wattai/affordable-inverted-pendulum/scripts/bests/at-2026-08-16/README.md

# 2026-08-16 時点の設計：モデルと制御則

[2026-08-15 版](../at-2026-08-15/README.md) からの更新版です。

| ファイル | 内容 |
| --- | --- |
| [design_best_R14_controller.py](design_best_R14_controller.py) | 物理パラメータから 10 状態モデルを組み、離散化して LQR ゲインを求める設計スクリプト |
| [arduino_uno_sketch.ino](arduino_uno_sketch.ino) | 実機（Arduino Uno）に書き込んだスケッチ。上記モデルの $A_d, B_d$、オブザーバゲイン $L$、LQR ゲイン $K$ が直値で埋め込まれている |
| [inverted_pendulum_speed_feedback_discussion.md](inverted_pendulum_speed_feedback_discussion.md) | 車輪速度フィードバックが効いていない件の考察（別 AI による整理）。要点は §11 に取り込み |

## 08-15 版からの変更点

**モデルに効いた変更はむだ時間だけです。** $0.100 \to 0.110$ s（実測値の採用）。

| | 08-15 | 08-16 | モデルへの影響 |
| --- | --- | --- | --- |
| むだ時間 $L_d$ | 0.100 s | **0.110 s** | あり（$\lambda$: 60 → 54.545） |
| 重心高さ $h$ | 0.080 m | 0.060 m | **なし**（約分で消える、§2） |
| 振り子周期 $T_p$ | 0.75 s | 0.75 s（据え置き） | — |

途中 $T_p = 0.45$ s という測定値で設計した版がありましたが、実機は逆走して破綻しました。これは測り方の問題で、詳細は §9-3 に記録してあります。

以下、記号・モデル・制御則を数式で示し、最後にコード上の実測値との対応と注意点をまとめます。

---

## 1. 記号と状態変数

| 記号 | 意味 | 単位 |
| --- | --- | --- |
| $\theta$ | 機体の傾き角（直立が 0） | rad |
| $\dot\theta$ | 機体の角速度 | rad/s |
| $\varphi$ | 左右車輪角の平均 | rad |
| $\omega$ | 車輪角速度（モータ 1 次遅れ後の値） | rad/s |
| $z_1,\dots,z_6$ | 入力むだ時間を近似する 1 次遅れ 6 段の内部状態 | rad/s |
| $u$ | 車輪速度指令（下位ループへの入力） | rad/s |

状態ベクトルは

$$
x = \begin{bmatrix}\theta & \dot\theta & \varphi & \omega & z_1 & z_2 & z_3 & z_4 & z_5 & z_6\end{bmatrix}^{\mathsf T}\in\mathbb R^{10}
$$

観測量は上位 4 成分（IMU の角度・角速度、エンコーダの角度・角速度）です。

$$
y = Cx,\qquad C = \begin{bmatrix} I_4 & 0_{4\times 6}\end{bmatrix}
$$

## 2. 物理パラメータ

| パラメータ | 記号 | 値 |
| --- | --- | --- |
| 制御周期 | $T_s$ | 0.010 s |
| 車輪半径 | $r$ | 0.027 m |
| 重力加速度 | $g$ | 9.8 m/s² |
| 機体質量 | $m$ | 0.350 kg（実測、9V 電池 50 g 込み。下記注意） |
| 重心高さ | $h$ | 0.060 m（同上） |
| 振り子周期（実測） | $T_p$ | 0.75 s |
| モータ 1 次遅れ時定数 | $\tau_m$ | 0.070 s |
| むだ時間 | $L_d$ | 0.110 s |
| むだ時間の分割段数 | $N$ | 6 |
| モータゲイン | $k_m$ | **1.99**（2026-08-16 実測、§13） |

機体の有効慣性モーメントは、実測した振り子周期 $T_p$ から逆算します。

$$
I_{\mathrm{eff}} = \frac{T_p^{2}\, m g h}{4\pi^{2}}
$$

むだ時間 1 段あたりの時定数と遅れレートは

$$
\theta_d = \frac{L_d}{N} = 0.018333\ \mathrm{s},\qquad
\lambda = \frac{1}{\theta_d} = \frac{N}{L_d} = 54.545\ \mathrm{s^{-1}}
$$

### 注意：$m$ と $h$ はモデルに影響しない

$I_{\mathrm{eff}}$ を上式で定義しているため、モデル行列に現れる 2 つの係数から $m,h$ が約分で消えます。

$$
a_\theta = \frac{m g h}{I_{\mathrm{eff}}} = \frac{4\pi^{2}}{T_p^{2}} = 70.183854\ \mathrm{s^{-2}}
$$

$$
a_{bw} = \frac{m h r}{I_{\mathrm{eff}}\,\tau_m} = \frac{4\pi^{2} r}{T_p^{2} g\, \tau_m} = 2.762338\ \mathrm{s^{-2}}
$$

つまりモデルは $T_p,\ r,\ g,\ \tau_m$ だけで決まります。実測値は $m = 0.350$ kg（9V 電池 50 g 込み、2026-08-16 計測）・$h = 0.060$ m で、設計スクリプトと Arduino スケッチはこの値を使っています。08-15 版から $h$ が 0.080 → 0.060 m に変わっていますが、**得られる $A_c$ は $T_p$ が同じである限り完全に同一**です。

ハードウェアの詳細は [ハードウェア仕様](../../../docs/specs/hardware/README.md) を参照してください。

## 3. 連続時間モデル

$$
\dot x = A_c x + B_c u
$$

各行の意味は次のとおりです。

$$
\begin{aligned}
\dot\theta &= \dot\theta \\
\ddot\theta &= a_\theta\,\theta + a_{bw}\,\omega - a_{bw}k_m\,z_1 \\
\dot\varphi &= \omega \\
\dot\omega &= -\frac{1}{\tau_m}\omega + \frac{k_m}{\tau_m} z_1 \\
\dot z_i &= \lambda\,(-z_i + z_{i+1}) \quad (i=1,\dots,5) \\
\dot z_6 &= \lambda\,(-z_6 + u)
\end{aligned}
$$

- 第 2 式：重力による倒立不安定項 $a_\theta\theta$ と、車輪の駆動反力による機体への逆トルク。実際に車輪を押す量は遅延後の指令 $z_1$ なので、$\omega$ と $z_1$ の差分が機体角加速度に効きます。
- 第 4 式：モータを 1 次遅れとみなし、遅延後の速度指令 $z_1$ に時定数 $\tau_m$ で追従。
- 第 5・6 式：Padé ではなく **1 次遅れ 6 段のカスケード**で $L_d = 0.110$ s のむだ時間を近似（$u \to z_6 \to \cdots \to z_1$ の向きに伝播）。

行列で書くと

$$
A_c=\begin{bmatrix}
0 & 1 & 0 & 0 & 0 & 0 & 0 & 0 & 0 & 0\\
a_\theta & 0 & 0 & a_{bw} & -a_{bw} & 0 & 0 & 0 & 0 & 0\\
0 & 0 & 0 & 1 & 0 & 0 & 0 & 0 & 0 & 0\\
0 & 0 & 0 & -\tfrac{1}{\tau_m} & \tfrac{1}{\tau_m} & 0 & 0 & 0 & 0 & 0\\
0 & 0 & 0 & 0 & -\lambda & \lambda & 0 & 0 & 0 & 0\\
0 & 0 & 0 & 0 & 0 & -\lambda & \lambda & 0 & 0 & 0\\
0 & 0 & 0 & 0 & 0 & 0 & -\lambda & \lambda & 0 & 0\\
0 & 0 & 0 & 0 & 0 & 0 & 0 & -\lambda & \lambda & 0\\
0 & 0 & 0 & 0 & 0 & 0 & 0 & 0 & -\lambda & \lambda\\
0 & 0 & 0 & 0 & 0 & 0 & 0 & 0 & 0 & -\lambda
\end{bmatrix},\qquad
B_c=\begin{bmatrix}0\\0\\0\\0\\0\\0\\0\\0\\0\\ \lambda\end{bmatrix}
$$

## 4. 離散化

ゼロ次ホールドで $T_s = 10$ ms 離散化します。

$$
A_d = e^{A_c T_s},\qquad B_d = \int_0^{T_s} e^{A_c s}\,ds\ B_c
$$

$$
x[k+1] = A_d x[k] + B_d u[k]
$$

得られる $A_d$（有効数字 6 桁）：

$$
A_d=\begin{bmatrix}
1.003511 & 0.010012 & 0 & 0.000132 & -0.000111 & -0.000019 & -0.000002 & 0 & 0 & 0\\
0.702660 & 1.003511 & 0 & 0.025772 & -0.019740 & -0.005020 & -0.000881 & -0.000118 & -0.000013 & -0.000001\\
0 & 0 & 1.000000 & 0.009319 & 0.000572 & 0.000096 & 0.000012 & 0.000001 & 0 & 0\\
0 & 0 & 0 & 0.866878 & 0.101945 & 0.025943 & 0.004555 & 0.000608 & 0.000065 & 0.000006\\
0 & 0 & 0 & 0 & 0.579578 & 0.316134 & 0.086218 & 0.015676 & 0.002138 & 0.000233\\
0 & 0 & 0 & 0 & 0 & 0.579578 & 0.316134 & 0.086218 & 0.015676 & 0.002138\\
0 & 0 & 0 & 0 & 0 & 0 & 0.579578 & 0.316134 & 0.086218 & 0.015676\\
0 & 0 & 0 & 0 & 0 & 0 & 0 & 0.579578 & 0.316134 & 0.086218\\
0 & 0 & 0 & 0 & 0 & 0 & 0 & 0 & 0.579578 & 0.316134\\
0 & 0 & 0 & 0 & 0 & 0 & 0 & 0 & 0 & 0.579578
\end{bmatrix}
$$

$$
B_d^{\mathsf T}=\begin{bmatrix}0 & 0 & 0 & 0 & 0.000023 & 0.000256 & 0.002394 & 0.018070 & 0.104288 & 0.420422\end{bmatrix}
$$

対角の $0.579578 = e^{-\lambda T_s} = e^{-0.5455}$、$0.866878 = e^{-T_s/\tau_m}$ です。

これらの数値は Arduino のオブザーバ予測式にそのまま直値で埋め込まれています。車輪速度の行の $B_d$ 成分は $10^{-6}$ 未満なので、スケッチでは省いています。

> **設計上の約束事**：LQR は $A_d, B_d$ を **小数第 6 位で丸めた行列**に対して解いています（`USE_ARDUINO_6_DECIMAL_MATRICES = True`）。Arduino に写した行列と設計用行列を一致させるためで、フル精度で解くとゲインがわずかにずれます。

## 5. オブザーバ（定常カルマンフィルタ）

観測できるのは 4 成分だけなので、$z_1..z_6$ を含む全状態を推定します。ゲイン $L$ は離散リカッチ方程式から求めた定常カルマンゲインです（$Q_{\mathrm{obs}} = I_{10}$、$R_{\mathrm{obs}} = I_4$）。

$$
P = A_d P A_d^{\mathsf T} - A_d P C^{\mathsf T}\left(C P C^{\mathsf T} + R_{\mathrm{obs}}\right)^{-1} C P A_d^{\mathsf T} + Q_{\mathrm{obs}}
$$

$$
L = P C^{\mathsf T}\left(C P C^{\mathsf T} + R_{\mathrm{obs}}\right)^{-1}
$$

実機で実装されている更新則は

$$
\hat x[k] = A_d\,\hat x[k-1] + B_d\,u[k-1] + L\left(y[k] - C\,\hat x[k-1]\right)
$$

$$
L=\begin{bmatrix}
0.604602 & 0.064385 & -0.000002 & 0.000098\\
0.064385 & 0.662635 & 0.000009 & 0.000106\\
-0.000002 & 0.000009 & 0.618044 & 0.000949\\
0.000098 & 0.000106 & 0.000949 & 0.604201\\
0.005900 & -0.022480 & 0.000900 & 0.152556\\
0.003641 & -0.014118 & 0.000513 & 0.095090\\
0.001942 & -0.007677 & 0.000263 & 0.051310\\
0.000857 & -0.003463 & 0.000111 & 0.022946\\
0.000280 & -0.001161 & 0.000034 & 0.007627\\
0.000051 & -0.000219 & 0.000006 & 0.001426
\end{bmatrix}
$$

推定誤差 $e = x - \hat x$ の同次項は

$$
e[k] = (A_d - LC)\,e[k-1] \;-\; LC(A_d - I)\,x[k-1]
$$

第 1 項の固有値は最大 $0.6797$（すべて単位円内）です。第 2 項は、イノベーションの基準に予測値 $\bar x[k] = A_d\hat x[k-1] + B_d u[k-1]$ ではなく 1 サンプル前の $\hat x[k-1]$ を使っているために現れる項で、$A_d - I = O(T_s)$ なので小さいものの、厳密には教科書的な current estimator とは一致しません。実機はこの形で安定に動いています。

推定車輪速度は $\pm 20\cdot 2\pi$ rad/s に飽和させています。

## 6. LQR（バランス制御器）

評価関数

$$
J = \sum_{k=0}^{\infty}\left( x[k]^{\mathsf T} Q\, x[k] + u[k]^{\mathsf T} R\, u[k]\right)
$$

離散代数リカッチ方程式

$$
P = A_d^{\mathsf T} P A_d - A_d^{\mathsf T} P B_d\left(R + B_d^{\mathsf T} P B_d\right)^{-1} B_d^{\mathsf T} P A_d + Q
$$

最適ゲイン（離散系の正しい形）

$$
K = \left(R + B_d^{\mathsf T} P B_d\right)^{-1} B_d^{\mathsf T} P A_d,\qquad u[k] = -K\,\hat x[k]
$$

重みは

$$
Q = \mathrm{diag}(10,\ 1,\ 1,\ 1,\ 0,0,0,0,0,0),\qquad R = 1.8
$$

$Q$ の第 3 要素（車輪角 $\varphi$）は 2026-08-16 に 0 → 1 へ変更しました。0 のままだと $\varphi$ が評価から外れて閉ループ極が 1.0 ちょうどに残り、機体が前後にうろつきます。1 にすると $K_\varphi \ne 0$ となって位置を保持し、その極が 0.9917 へ移動します。得られる全ゲインは

$$
K_{\mathrm{full}} = \begin{bmatrix}-237.705891 & -28.381120 & -0.663467 & -3.484149 & 0.906499 & 0.785472 & 0.676866 & 0.577751 & 0.486363 & 0.403040\end{bmatrix}
$$

### 実機に載せた制御則

実験の結果、$z_1..z_6$ を直接フィードバックするより**上位 4 状態だけを使う**方がはるかに安定でした。したがって実装は

$$
u[k] = -K_\theta\hat\theta - K_{\dot\theta}\hat{\dot\theta} - K_\varphi\hat\varphi - K_\omega\hat\omega
$$

$$
K_\theta = -237.705891,\quad K_{\dot\theta} = -28.381120,\quad K_\varphi = -0.663467,\quad K_\omega = -3.484149
$$

$$
\Rightarrow\quad u[k] \approx 237.71\,\hat\theta + 28.38\,\hat{\dot\theta} + 0.66\,\hat\varphi + 3.48\,\hat\omega \quad [\mathrm{rad/s}]
$$

（$\hat\theta$ には後述の位置ホールド用トリムが引かれますが、既定では無効です。）

### 閉ループ極

| 構成 | 最大 $|\lambda|$ |
| --- | --- |
| 全 10 状態 LQR（$K_{\mathrm{full}}$） | 0.991736 |
| 実機構成（$z$ ゲインを 0 に切り落とした 4 状態） | 1.099362 |
| オブザーバ誤差 $A_d - LC$ | 0.683314 |

$Q_\varphi = 1$ としたことで、以前は 1.0 ちょうどに居座っていた車輪角の積分器モードが 0.9917 に入りました。$Q_\varphi = 0$ では $\varphi$ が可安定だが不可検出でモードが中立になり、機体が前後にうろつく原因になっていました。

4 状態版の $1.099$ は、**この 10 状態公称モデル単体では発散する**ことを意味します。設計スクリプト自身もこれを警告として出力します。ただし実機にはオブザーバ、下位のモータ／PWM ループ、エンコーダ特性、飽和、モデル誤差が加わっており、実験的には $z$ を直接フィードバックする構成より 4 状態構成の方が明確に良好でした。このスクリプトは「理論上の全状態 LQR」と「実際に成功した実装ゲイン」の両方を再現するためにこの形になっています。

## 7. 下位ループ（左右同期 + leaky PI）

上位が出した速度指令 $u$ を、左右 2 輪の PI ループへ渡します。$\varphi_A,\varphi_B$ を左右の車輪角、$\omega_A,\omega_B$ を左右の車輪速度として

$$
\Delta = \varphi_B - \varphi_A
$$

$$
e_A = u - \omega_A + k_{\mathrm{sync}}\Delta,\qquad
e_B = u - \omega_B - k_{\mathrm{sync}}\Delta
$$

積分項は漏れ（leaky）付きで、$\rho = 0.99$（時定数 $\approx T_s/(1-\rho) = 1$ s）：

$$
I_A[k] = e_A[k]\,T_s + \rho\, I_A[k-1],\qquad I_B[k] = e_B[k]\,T_s + \rho\, I_B[k-1]
$$

$$
u_A = \mathrm{sat}_{[-1,1]}\!\left(k_{pA} e_A + k_{iA} I_A\right),\qquad
u_B = \mathrm{sat}_{[-1,1]}\!\left(k_{pB} e_B + k_{iB} I_B\right)
$$

| パラメータ | 値 |
| --- | --- |
| $k_{\mathrm{sync}}$ | 1.20 |
| $k_{pA},\ k_{pB}$ | 0.025, 0.030 |
| $k_{iA},\ k_{iB}$ | 0.040, 0.050 |
| 積分漏れ $\rho$ | 0.99 |

左右で $k_p, k_i$ が非対称なのは、安定していたコードの実測値をそのまま残しているためです。$u_A, u_B$ は duty 比としてそのまま PWM に出力されます。

## 8. センサ処理と保護

- **機体角**：BNO055 の Euler-z からオフセット（起動時 300 サンプルの平均）を引いて rad へ変換。$|z| < 20^\circ$ の領域は Euler 表現が乱れるため、前回値を保持する処理を意図的に残しています。
- **機体角速度**：BNO055 ジャイロ $-\dot x$ をそのまま使用。
- **車輪角**：A/B 相を高速ポーリングして計数。ギア比が左右で異なります。

$$
\varphi_A = \mathrm{cnt}_A\cdot\frac{20}{14}\cdot\frac{2\pi}{48},\qquad
\varphi_B = \mathrm{cnt}_B\cdot\frac{20}{12}\cdot\frac{2\pi}{48}
$$

$$
\varphi = \frac{\varphi_A + \varphi_B}{2},\qquad \omega = \frac{\bar\omega_A + \bar\omega_B}{2}
$$

- **車輪速度の生値**：1 次 IIR で平滑（$\alpha = 0.8$）。
- **転倒保護**：$|\theta| > 35^\circ$ でモータ停止・積分器リセット。
- **タイミング**：MsTimer2 による 10 ms 周期（100 Hz）。ログは 1/5 に間引いて 20 Hz。

## 9. 実装上の注意（既知の差異）

実機の挙動を再現するうえで重要な、コードとモデルの食い違いです。**いずれも「安定していた状態を壊さない」ために意図的に、あるいは結果的に残されています。**

1. **`angleSpeedAverageA/B` は恒等的に 0**
   [arduino_uno_sketch.ino:572-578](arduino_uno_sketch.ino#L572-L578) の更新は `angleSpeedAverageA += angleSpeedAverageA / 100` という自己参照で、初期値 0・毎制御周期末に 0 リセットされるため、値は常に 0 のままです。結果として
   - オブザーバの第 4 観測 $y_4 \equiv 0$（イノベーション $e_4 = -\hat\omega$ になる）
   - 下位 PI の速度フィードバックが実質無効化され、$e_A = u + k_{\mathrm{sync}}\Delta$ となる

   コード中のコメントでも「下位ループを一から再調整しない限り直すな」と明記されています。

2. **モード名と中身の $R$ は一致させてあります（08-15 版からの変更）**
   08-15 版は `MODE_R14_4STATE` という名前のスロットに $R = 1.0$ の解が入っており、08-16 の実験で混乱の一因になりました。現在は `MODE_R18_4STATE`（$R = 1.8$、既定）と `MODE_R30_4STATE`（$R = 3.0$）で、名前と設計値が一致しています。参考用の `gainZ1..gainZ6` も $R = 1.8$ で統一しました。

3. **振り子周期 0.45 s は測定アーティファクト**
   車軸に紐を結んで測った 0.45 s は、紐自体が振れる 2 自由度系の固有モードであり、モデルが仮定する「車軸を固定した 1 自由度の剛体振り子」ではありません。平行軸定理より $T_p \ge 2\pi\sqrt{h/g} = 0.492$ s（$h = 0.060$ m）なので、0.45 s は車軸まわりの回転としては原理的に成立しません。爪で車軸を吊って測った 0.75 s を採用しています。

4. **位置ホールド外ループは既定で無効**
   `ENABLE_SLOW_POSITION_HOLD = false`。有効にすると 10 Hz で機体角の目標にトリムを加えます。

$$
\theta_{\mathrm{trim}}[k] = \alpha_p\,\theta_{\mathrm{trim}}[k-1] + (1-\alpha_p)\,\mathrm{sat}_{\pm 0.5^\circ}\!\left(-K_{\mathrm{pos}}(\varphi - \varphi_{\mathrm{ref}})\right)
$$

$$
\theta_{\mathrm{ctrl}} = \hat\theta - \theta_{\mathrm{trim}},\qquad K_{\mathrm{pos}} = 0.0010,\ \ \alpha_p = 0.90
$$

## 10. 再現方法

```bash
uv sync
uv run python scripts/bests/at-2026-08-16/design_best_R14_controller.py
```

物理パラメータ → $A_c, B_c$ → ZOH 離散化 → 6 桁丸め → 離散 LQR → Arduino 用定数ブロック、の順に出力されます。$R$ を 1.0〜1.8 で振ったスイープも最後に表示されます。

末尾の再現チェック（`EXPECTED_R14_FULL`）は本構成の $R = 1.4$ 解に更新済みで、`PASS` が出ます。

オブザーバゲイン $L$ はこのスクリプトでは計算していません。[../../system-design/calc-optimal-gain-v6.py](../../system-design/calc-optimal-gain-v6.py) の `calculate_discrete_observer_gain(A_d, C_d, I_10, I_4)` が上記 $L$ を再現します。

## 11. アクチュエータ経路の実態と設計上の含意

[inverted_pendulum_speed_feedback_discussion.md](inverted_pendulum_speed_feedback_discussion.md) の考察から、設計判断に直結する部分を要約します。§9-1 で述べた「車輪速度フィードバックが効いていない」という事実を、**なぜそれで性能が良いのか**という観点から整理したものです。

### 11.1 設計モデルの $u$ と実機の $u$ は意味が違う

設計モデルは入力を「車輪速度指令」として扱っています。

$$
u \;\longrightarrow\; \text{6 段むだ時間}\;\longrightarrow\; \frac{1}{\tau_m s + 1} \;\longrightarrow\; \omega
$$

一方、実機の経路は §9-1 のとおり速度フィードバックが不在なので、

$$
u_{\mathrm{LQR}} \;\longrightarrow\; \text{弱い P + リーク I} \;\longrightarrow\; \mathrm{PWM} \;\longrightarrow\; \text{モータ}
$$

であり、実質「LQR 出力 ≒ 直接 PWM」に近い構造です。**モデルの $u$（速度指令）と実機の $u$（ほぼ電圧指令）は物理的な意味が一致していません。** 現在のゲインは、この不一致を含んだまま実験的に良好だった設定である、と理解しておく必要があります。

### 11.2 むだ時間が不安定化の時定数と同じオーダー

倒立振子の不安定極は $\lambda = \sqrt{a_\theta} = 2\pi/T_p$ です。

$$
\lambda = \frac{2\pi}{0.75} = 8.38\ \mathrm{s^{-1}},\qquad
\frac{1}{\lambda} = 0.119\ \mathrm{s}
$$

これに対して実測むだ時間は $0.110$ s です。**入力が効き始める前に、機体は倒れの時定数のほぼ 1 つぶん進んでしまいます。** この系で下位速度ループを追加すると、

- エンコーダ速度推定の遅れ
- フィルタ遅れ
- PI の応答遅れ

がさらに積み上がります。速度ループをバイパスして姿勢に直接反応する現在の構造の方が実機で良かったのは、この遅れ収支で説明がつきます。**「バグを直す」ことが「性能が上がる」ことを意味しない**のはこのためです。

### 11.3 うまくいかなかった手法とその理由

| 試した手法 | 結果 | 考えられる理由 |
| --- | --- | --- |
| $z_1..z_6$ の直接フィードバック | 大幅に悪化 | $z$ は実測ではなくモデル依存の仮想状態。実むだ時間 0.11 s とモデル 0.10 s のずれ（1 サンプル）に敏感。「もう効くはず」と先回りして入力を弱めるが、実際にはまだモータが反応していない |
| $\Delta u$ ペナルティ付き拡大 LQR | 姿勢に追従せず | 入力を滑らかにする方向の制約が、むだ時間の大きい系では致命的。4 状態から 11 状態へ一度に変えたことも切り分けを困難にした |
| 平衡点近傍でゲインを 0.75 倍 | ギコギコ悪化 | 線形 LQR が最も有効な領域で安定余裕を削る形になる。ゲインスケジュールが非線形切替として働く |
| **$R$ を 1.0 → 1.2 → 1.4 と増やす** | **改善（ベスト）** | 実行時のスケーリングではなく評価関数から再設計するため、閉ループ全体として整合が取れる |

### 11.4 速度フィードバックを再導入する場合

単純に「LQR → 速度 PI → PWM」に戻すと §11.2 の遅れが乗ります。導入するならフィードフォワード主体の形が有力です。

$$
\mathrm{PWM} = K_{\mathrm{ff}}\,u_{\mathrm{LQR}} + K_p\left(u_{\mathrm{LQR}} - \omega\right) + K_i\int\left(u_{\mathrm{LQR}} - \omega\right)dt
$$

第 1 項で現在の速い直接駆動を残し、PI は弱い補正として使います。これなら姿勢追従の速さと実車輪速度の補正を両立できる可能性があります。**導入する場合は必ず現構成と別系統として A/B 比較してください。**

### 11.5 元文書との差異

考察文書の §21-9 は「振り子周期は 0.45 s 前後の可能性があり再同定する」としていますが、これは本 README の §9-3 で否定されています（0.45 s は紐で吊った 2 自由度系のモード。$h = 0.060$ m では原理的に 0.492 s を下回れません）。文書の他の項目はこの点に依存していません。

また、考察文書の §4・§17 が挙げるベストゲイン $(-359.683,\ -42.941,\ -0.765,\ -5.269)$ は 08-15 以前の $Q_\varphi = 1$ 系のもので、現在のスケッチに入っている値とは系統が異なります（§9-2）。

### 11.6 次に測るべきもの

現在の最大の未知は §11.1 の入力の意味の不一致です。`u_WheelAngleSpeed` → PWM → 実車輪速度の伝達特性を実測し、次のモデルの入力段をそれに置き換えるのが、この構成で残っている一番大きな改善余地です。

## 12. $R$ の実験結果と、$R$ というノブの限界

### 12.1 実機での結果（2026-08-16）

| $R$ | ゲイン（$R=1.0$ 比） | 実機 |
| --- | --- | --- |
| 1.0 | 1.000 | **発散。すぐ倒れる** |
| 1.6 | 0.943 | 安定。ギコギコは残る |
| 1.8 | 0.931 | 安定。ギコギコは残る ← **既定** |

わずか 6 % のゲイン差が発散と安定の境目になっており、**安定余裕がほとんどない状態**です。

### 12.2 $R$ には下限がある

$R$ を上げてもゲインは無限には下がりません。

| $R$ | $K_\theta$ | $R=1.0$ 比 |
| --- | --- | --- |
| 1.8 | −350.16 | 0.931 |
| 3.0 | −335.62 | 0.893 |
| 10 | −318.79 | 0.848 |
| 1000 | −311.03 | **0.827（限界）** |

不安定な系では、LQR は「不安定極を安定化するのに最低限必要なゲイン」より下に行けません（$R \to \infty$ の極限は最小エネルギー安定化解であって、ゼロではない）。さらに $K_{\dot\theta}/K_\theta = 0.1194$ は **$R$ によらず一定**です。

$$
\boxed{R\ \text{はゲインベクトルの向きを変えず、大きさを最大でも } 0.827\ \text{倍までしか縮められない}}
$$

$1.8 \to 3.0$ で稼げるのは 4 % です。ここから先の余裕は $R$ では作れません。

### 12.3 効くノブはモータゲイン $k_m$

実機が $R=1.0$ で発散するということは、**同じ $u$ に対して実機のアクチュエータがモデルより強い**ということです。§11.1 の「モデルの $u$ は車輪速度指令、実機の $u$ はほぼ電圧指令」という不一致がここに現れています。

正攻法はモデルの入力段にモータゲイン $k_m$ を入れることです。

$$
\dot\omega = -\frac{1}{\tau_m}\omega + \frac{k_m}{\tau_m} z_1,\qquad
\ddot\theta = a_\theta\theta + a_{bw}\omega - a_{bw} k_m z_1
$$

$R = 1.6$ 固定で $k_m$ を振った場合：

| $k_m$ | $K_\theta$ | $K_{\dot\theta}$ | $K_\omega$ | $R=1.0,k_m=1$ 比 |
| --- | --- | --- | --- | --- |
| 1.00 | −354.45 | −42.32 | −5.14 | 0.943 |
| 1.25 | −300.01 | −35.82 | −4.35 | 0.798 |
| 1.50 | −264.58 | −31.59 | −3.83 | 0.704 |
| 2.00 | −222.25 | −26.54 | −3.21 | 0.591 |

$R$ では到達できない領域に素直に届き、しかも $K_\omega$ が相対的に強く下がるため**ゲインの向きも変わります**（単なる一律スケーリングとは別物）。

なお、これは考察文書 §15 で失敗した「平衡点近傍だけゲインを 0.75 倍」とは異なります。あちらは状態依存の非線形切替でしたが、$k_m$ は全域一定のモデル修正であり、閉ループとしての整合は保たれます。

### 12.4 $k_m$ を当てずっぽうにしないために

$k_m$ を推測で決めるより、実測するのが筋です（§11.6）。[data/motor-calibration.jsonl](../../../data/motor-calibration.jsonl) を取ったのと同じ要領で、既知のデューティに対する定常車輪速度を数点測れば、$u \to$ 実車輪速度の直流ゲインとして $k_m$ が直接求まります。現在の構成で残っている改善余地としては、これが最も大きいはずです。

## 13. アクチュエータの実測（2026-08-16）とモデルへの反映

[km 同定用の計測](../../motor-calibration/km-identification/)で、デューティ → 車輪速度を直接測りました。結果はモデルの前提を 3 か所で覆しました。

### 13.1 Timer2 競合が実測で確定（最重要）

1 回目の計測（MsTimer2 を有効にしたまま）で、**B 輪は duty 0.1〜0.9 で 1 カウントも動かず、duty = 1.00 でだけ回りました。**

| duty | A 輪 [rad/s] | B 輪 [rad/s] |
| --- | --- | --- |
| 0.40 | 24.7 | **0** |
| 0.60 | 44.1 | **0** |
| 0.90 | 51.6 | **0** |
| 1.00 | 50.8 | **40.0** |

`analogWrite(pin, 255)` だけが `digitalWrite(HIGH)` に落ちる Arduino core の特例と完全に一致します。MsTimer2 が Timer2 を占有するため、Timer2 に属する D3 / D11 では PWM が出ていませんでした。

| モータ | 正転 | 逆転 |
| --- | --- | --- |
| A | D9（Timer1）→ 正常 | D3（Timer2）→ 死んでいた |
| B | D11（Timer2）→ 死んでいた | D10（Timer1）→ 正常 |

**これまでの実機は、各モータが片方向にしか駆動できない状態でバランスしていた**ことになります。左右の PI ゲインを非対称にする必要があったことも、$k_{\mathrm{sync}} = 1.20$ という強めの同期ゲインが要ったことも、これで説明がつきます。

計測スケッチから MsTimer2 を外し（制御周期を `micros()` で刻む方式に変更）、2 回目の計測では両輪とも全デューティ域で応答しました。

> **バランス用スケッチにはこの修正をまだ入れていません。** 入れると挙動が根本的に変わり、ゲインの再調整が前提になります。別途の判断事項です。

### 13.2 モータゲイン $k_m \approx 2$（本節で反映済み）

2 回目の計測から、デューティ → 車輪速度の直流ゲインは

$$
G_A = 69.9,\qquad G_B = 68.0\quad [\mathrm{rad/s\ per\ duty}]
$$

下位ループの $\mathrm{duty}/u$ は不安定極 8.38 rad/s において $0.0262$（A）/ $0.0315$（B）なので

$$
k_{m,A} = 1.83,\qquad k_{m,B} = 2.14,\qquad k_m = \frac{k_{m,A}+k_{m,B}}{2} = 1.99
$$

モデルの $\omega$ は左右平均なので平均値を採ります。**実機のアクチュエータは、これまでの設計が仮定していた 2 倍近く強い**ということです。$R = 1.0$ が発散し $R = 1.6$ 以降で安定した実験結果と整合します。$R$ では $0.827$ 倍までしか下げられないので、この 2 倍のずれは $R$ では吸収できませんでした。

反映後のゲインは $R = 1.8$ で

$$
K = \begin{bmatrix}-217.27 & -25.94 & 0 & -3.14\end{bmatrix}
$$

となり、$k_m = 1$ 時代の $-350.16$ から 0.62 倍に下がりました。

### 13.3 不感帯（本節で反映済み）

空転状態でも、A 輪は duty 0.25 程度、B 輪は 0.35 程度まで**まったく動きません**。ギヤボックスの摩擦です。バランス制御が出すデューティは $0.025 \times u$ 程度なので、$u \lesssim 10$ rad/s、すなわち**傾き 2° 以下ではモータが一切反応しません**。ギコギコの主犯はこれと考えられます。

下位ループの出力に、破断デューティを足し戻す補償を入れました。

$$
\mathrm{duty} = \mathrm{sign}(u)\left(d_0 \cdot \alpha + |u|\right),\qquad
d_{0,A} = 0.25,\ d_{0,B} = 0.35,\ \alpha = 0.8
$$

$\alpha = 0.8$ と意図的に過小補償しています。不感帯を厳密に打ち消すとゼロ交差ごとに $d_0$ のジャンプが乗り、過補償するとそれ自体がリミットサイクルの原因になるためです。$|u| < 0.002$ は 0 に丸め、直立点でのノイズが出力を $\pm d_0$ 間で暴れさせないようにしています。

`ENABLE_DEADZONE_COMPENSATION = false` で無効化でき、従来挙動との A/B が取れます。

### 13.4 モータ時定数（未反映）

ステップ応答を 1 次遅れと定加速度（電流制限）で比較すると、1 次遅れの方が明確に良く合いました（残差 RMS 0.07 対 0.12〜0.35）。ただし時定数が

$$
\tau_m \approx 0.44 \sim 0.82\ \mathrm{s}\quad(\text{モデルの仮定は }0.070\ \mathrm{s})
$$

と**約 7〜10 倍**です。これが正しいなら、

| | 周波数 | 時定数 |
| --- | --- | --- |
| 倒立の不安定極 | 8.38 rad/s | 0.119 s |
| アクチュエータ極（実測） | 2.0 rad/s | 0.5 s |

**アクチュエータが不安定極より 4.2 倍遅い**ことになり、むだ時間以前にこれがこの機体の根本的な難しさということになります。

$\tau_m$ を反映すると $a_{bw} = 4\pi^2 r/(T_p^2 g \tau_m)$ も変わり、$k_m$ と合わせた再設計では $K_\theta = -647$ と現行の 3 倍近い強いゲインになります（アクチュエータが遅いぶん強く叩かないと間に合わない、という解）。

**この値はスタンド上の空転での測定です。** 接地時は機体の質量も加速するため実効的にはさらに遅くなる可能性があり、いきなり $K_\theta = -647$ を実機に載せるのは危険と判断して、本版では見送りました。接地状態で同じ階段を与えて再測定してから反映するのが安全です。
