wattai/affordable-inverted-pendulum/(commit log)

2024-11-19 Add some codes for Arduino
2026-08-16 現時点2026-08-15でのベストスケッチとその設計スクリプトを記録した.
2026-08-16 これまでの stable 版のスクリプトを記録した.
2026-08-16 ドキュメント類を最新化した.
2026-08-16 パッケージ管理を uv へ移行し、ドキュメントを更新した.
2026-08-16 video タグが GitHub 上では無視されてしまうため gif 画像としてデモ動画を掲載した.
2026-08-16 ハードウェアに関するドキュメントを追加した.
2026-08-16 wip: アクチュエータ周りが上位モデルと一致するようにしている
